dfannin/lart1/schematic/LART1-v6-micro-board.png

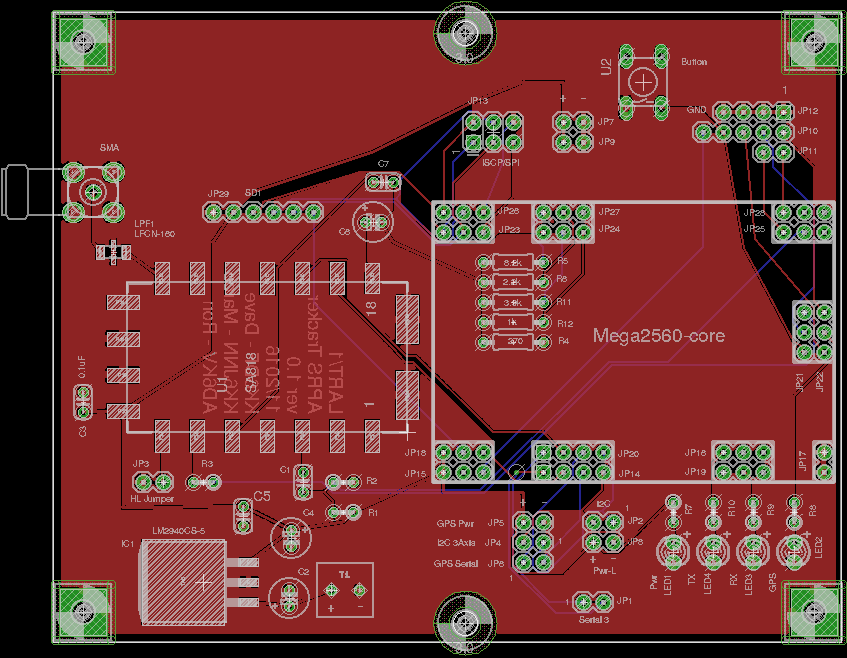
schematic/LART1-v6-micro-board.png
