dfannin/lart1/schematic/LART1-v6a-micro-schematic.png

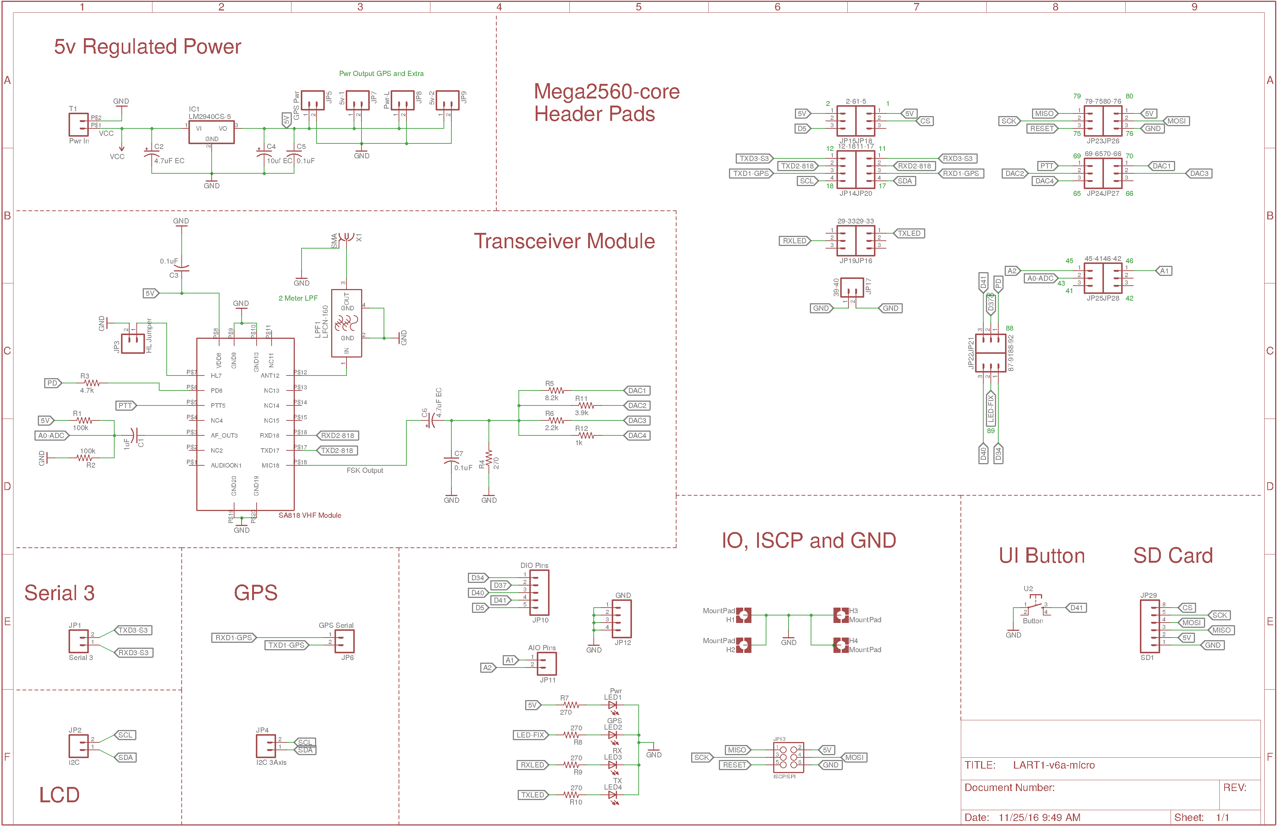
schematic/LART1-v6a-micro-schematic.png
