dfannin/lart1/(threads)

Thread 1 (2016-10-22):

SD Card Interface

dfannin, 2016-10-22:
Desired Features
- add SD card interface
-  read  and set configuration data from SD card (
-  should have a #define switch
- if SD card or data error, then fail to start up

Acceptance Test
- Read and set sample config data
- handle error (fail to startup) on data error

Closed 2016-10-24.

Thread 11 (2016-10-23):

LED pin control for GPS, TX, RX, Pwr

dfannin, 2016-10-23:
Desired Features:
add LED pin control for GPS fix (fix=on)
confirm and test TX/RX LED pins working

Closed 2016-11-01.

Thread 16 (2016-11-02):

Changes for 1.0 Design (Design Review 1)

dfannin, 2016-11-02:
# Changes from the Design Review of Hardware Board

+ Remove SD 2 row Headers, replace SD connector with Mini-SD card connector layout (single row pins)
  + plan to use miniSD card module, relocate on board with no overhang
+ PTT - don't need mosfet switch, just use arduino pins (reverse logic)
+ add add' bypass cap near voltage regulator ic
+ make sure power traces are sized for 1 amp
+ review power input terminal screw block - is the orientation correct? review Poloru to see if clamp down wago connects can be used.
+ group interfacing pins (gps, lcd, etc)  into common blocks  1x or 2x rows. use std sizes
+ add gnd pads to led, to allow board mounting of leds (blinkenlights)
+ add power indicator led (board or remote)
+ tie in ground pour and corner holes ground planes.
+ add test pads to the board.
+ review 818 pads to make sure ground pads work for DRA or SA models.
+ make sure the Mega2560-core pins to usb cable have clearance to be connected after installed.
+ mounting holes for LCD display.
+ alternatives to using SD card for configuration.

dfannin, 2016-11-04:
# Changes made (board v6)

+ (done)  Remove SD 2 row Headers, replace SD connector with Mini-SD card connector layout (single row pins)
  + plan to use miniSD card module, relocate on board with no overhang
+ (done)  PTT - don't need mosfet switch, just use arduino pins (reverse logic)
+ (done) add add' bypass cap near voltage regulator ic
+ (done) make sure power traces are sized for 1 amp - 12mil
+ (done)  review power input terminal screw block - is the orientation correct? review Poloru to see if clamp down wago connects can be used. - NC
+ (done) group interfacing pins (gps, lcd, etc)  into common blocks  1x or 2x rows. use std sizes
+ (done) add gnd pads to led, to allow board mounting of leds (blinkenlights)
+ (done) add power indicator led (board or remote)
+ (done) tie in ground pour and corner holes ground planes.
+  add test pads to the board.
+ (done) review 818 pads to make sure ground pads work for DRA or SA models. -OK
+ (done) make sure the Mega2560-core pins to usb cable have clearance to be connected after installed.
+ (done) mounting holes for LCD display. - added two holes
+ (done) alternatives to using SD card for configuration. - NC

dfannin, 2016-11-04:
# Changes made (board v6)

+ (done) added UI button (tactile switch)
+ (done) added LED outline

Closed 2016-11-05.

Thread 17 (2016-11-06):

Add flexible PTT logic setting

dfannin, 2016-11-06:
Add ability to set PTT logic to ON=true, or OFF=false, or the reverse.  Hardware design updated to remove Mosfet Switch, so the default is now ON=LOW, OFF=HIGH on PTT pin.

Closed 2016-11-07.

Thread 18 (2016-11-06):

Add PD (Power Down) logic for Transceiver

dfannin, 2016-11-06:
Add Arduino code to set PD logic pin to HIGH for operation, and low for power down.
Current behavior for 1.0 will be to set and leave it HIGH.
Pin Number should be set in the #define.

Closed 2016-11-09.

Thread 22 (2016-11-21):

Reversed Jmp16 and Jmp19 on V6 board - breaks TX/RX led assignments

dfannin, 2016-11-21:
the board layout for V6 was incorrect - Jmp 16 and 19 were swapped on the layout. This breaks the LED pin assigments for TX and RX led pins.  Luckily, this can be fixed by reassigning TX to pin D49 and RX to pin D46, and changing the LibAPRS to use DDR pins L0 for TX and L3 for RX.

Closed 2016-11-21.

Thread 26 (2018-06-03):

PCB - add additional ground pad for the voltage regulator

dfannin, 2018-06-03:
PCB - Adding additional space for the SMD voltage regulator ground pad and a thru hold to make it easier to solder on the VR

Thread 27 (2018-06-03):

PCB - remove excess pins and devices

dfannin, 2018-06-03:
- reducing the LEDs from 4 to 1 (maybe zero, and just the Arduino LED)
- remove the 2x3 ISCP pins (jp13)
- remove the 2x2 extra power out pins. (jp7and9)
-  remove the extra IO pins (JP10/11/12) (maybe keep 2 or 3)
-  remove the i2c 3 axis pins (JP4)
-  remove LCD mounting holes remove the LCD i2c and pwr pins ( JP2 and JP8)
-  remove the tactile switch
Most of these were not being used, so it frees up a lot of board space (and power consumption, in the case of the LEDs).  I can reduce the board width about 20mm  with these changes. (from 10x8cm to 10x6cm.  I may leave some of these as holes if I have room.  A lot of these boards are used without the LCD anyway, and its a significant savings for power consumption.

Thread 28 (2018-06-03):

PCB - Change pins to JST-XH

dfannin, 2018-06-03:
Changing the wiring pins (for the GPS, Power Input and Output, and serial port to JST-XH style connectors.

Thread 32 (2018-06-04):

PCB - add header for connecting USB

dfannin, 2018-06-04:
Add header (2 wire d+/d-) JST-XH header for connecting USB cable
also look at option to put USB cable on the board directly (micro-usb)

Thread 34 (2019-11-27):

PCB - please add Gerber file for board

heypete, 2019-11-27:
Hi,

Could you please share the Gerber file for the PCB so one could have the board made?

Thank you.
