dfannin/lart1/LART1.ino

/*
 * Livermore Amateur Radio Klub (LART) APRS Tracker (LART/1)
 *
 * Provides (Automatic Position Reporting System) APRS tracker features that can be used 
 * as an GPS location transmitter "beacon" , and can also function as an  APRS packet receiver.     
 * The design is designed to integrate  the DRA818v/SA818v 2 meter 1 watt transceiver module, and
 * a NMEA compatible GPS module.  
 *
 * The following libraries are required (modified libraries are provided in the repository):
 * LibAPRS - provides the software TNC featuree
 * DRA818 - controls the  2 meter transceiver
 * TinyGPSplus - parses the GPS messages
 * LiquidCrystal_I2C (optional) - provides LCD display
 *
 * The hardware specifications and schematic are provided in the repository. It is designed to
 * run on a Arduino Mega2560 compatible board.
 * 
 * Author: David Fannin, KK6DF
 * Created: October 2016 
 * License: MIT License
 * Licenses and Copyright Notices for Modified Libraries are retained by the original authors. 
 *
 */

#if defined(__AVR_ATmega2560__) 
#define TARGET_CPU mega2560
#endif

#include "Arduino.h" 
#include <avr/sleep.h>
#include "LART1_Settings.h"
#include "LiquidCrystal_I2C.h"
#include "LibAPRS.h"
#include "TinyGPSplus.h"
#include "DRA818.h"
#include "Log.h"
#include "SD.h"
#include "ClickButton.h"

#define VERSION "1.002b"
#define ADC_REFERENCE REF_5V
// various debug flags
// #define DEBUG_APRS_SETTINGS
// #define DEBUG_POSITIONCHECK

// setting DRA818 Filter settings
// transciver filter settings 
// note: "true" bypasses the  filter (turns the filter off), "false"  sets to normal mode (turns on) 
// yes, this is confusing!
#define FILTER_PREMPHASIS false
#define FILTER_HIGHPASS true
#define FILTER_LOWPASS true

//  define APRS_PTT_LOW for TX=LOW hardware
//  or APRS_PTT_HIGH for TX=HIGH hardware
#define APRS_PTT_TX_LOW 

// status led 
//
#define LED_TX 49
#define LED_RX 46
#define LED_GPS 36

#define LED_13 13
//
// Transceiver Ctl pins
// PTT pin (don't change, the pin is used by Port Manipulation later on) 
#define PTT 25

// PowerDown Logic Pin (puts DRA818 into sleep mode)
#define PD 35 

// on-board tactile button (UI button)
// use pullup , so button is active low 
#define BTN1 41
ClickButton btn1(BTN1, LOW, CLICKBTN_PULLUP) ;
int btn1_function = 0 ;

// usb serial port
HardwareSerial  * serialdb   = &Serial ;
// gps port
HardwareSerial  * serialgps  = &Serial1 ;
// DRA818 port
HardwareSerial * dra_serial = &Serial2 ;

// setting the default parameters
char aprs_callsign[7] ;
bool callsign_set = false ;
int  aprs_ssid ;
bool ssid_set = false ;
char aprs_comment[36] ;
bool aprs_beacon = APRS_BEACON  ;
bool aprs_recv = APRS_RECV ;
bool notsosmart_beacon = NOTSOSMART_BEACON ; 
bool sdlog_write = SDLOG_WRITE ;
double txfreq = TXFREQ ;  
double rxfreq = RXFREQ ;
int txctcss = TXCTCSS ;
int rxctcss = RXCTCSS ;
int volume = VOL ;
int squelch = SQUELCH ;

bool open_squelch = OPEN_SQUELCH ;
char aprs_dest[7]  ;
char aprs_path1[7] ;
int aprs_path1_ssid =PATH1_SSID ;
char aprs_path2[7] ;
int aprs_path2_ssid = PATH2_SSID ;
int  preamble = PREAMBLE;
int  tail = TAIL;
char aprs_symbol  = SYMBOL ;
bool aprs_alt_symbol = USE_ALT_SYM_TABLE  ;
unsigned long bklight_interval = BKLIGHT_INTERVAL ;

unsigned long update_beacon = UPDATE_BEACON_INIT ;

unsigned long update_beacon_fixed = UPDATE_BEACON_FIXED ;
unsigned long update_beacon_moving = UPDATE_BEACON_MOVING ;

// set the outer beacon check loop to 30 seconds (do not change).
unsigned long update_check = 30000L ;
unsigned long lastcheck = 0 ;
unsigned long lastupdate = 0 ;
unsigned long lastupdatedisplay = 0 ;
unsigned long lastgpsupdate = 0 ;

float mph_threshold = MPH_THRESHOLD ;

unsigned long update_led = 0 ;
unsigned long update_led_interval = 500UL ;


int sent_count=0 ;

#if OPTION_LCD
LiquidCrystal_I2C lcd(0x27, 2, 1, 0, 4, 5, 6, 7 , 3, POSITIVE); 
unsigned long bklighttimer = 30000UL ;
#endif
bool bklightstate = true ;


// GPS 
TinyGPSPlus gps ;

// DRA818 Transceiver Module
DRA818 dra(dra_serial, PTT);

// Log
Log mylog;


char buf[120] ;

boolean gotPacket = false ;
int recv_count = 0 ;
AX25Msg incomingPacket;
uint8_t *packetData;

void aprs_msg_callback(struct AX25Msg *msg)
{
   if(!gotPacket) {
      gotPacket = true ;
      memcpy(&incomingPacket, msg, sizeof(AX25Msg));
      if (freeMemory() > (int16_t)  msg->len) {
         packetData = (uint8_t*) malloc(msg->len);
         memcpy(packetData,msg->info,msg->len);
         incomingPacket.info=packetData;
      } else {
         gotPacket = false ;
      }
   }
}


void processPacket()
{
   if(gotPacket) {
      char outbuf[180] ; 
      char tmpbuf[120];

      gotPacket = false ;
      recv_count++ ;

      outbuf[0] = '\0';
      strcpy(tmpbuf,"00-00 00:00:00 ") ;

      if ( aprs_recv ) {

          if( gps.date.isValid() ) {
              sprintf(tmpbuf,"%02d-%02d %02d:%02d:%02d ", 
                      gps.date.month(), gps.date.day(),
                      gps.time.hour(), gps.time.minute(), gps.time.second()
                     ) ;
          } 


          strcat(outbuf,tmpbuf) ;

          sprintf(tmpbuf,"%s-%d,%s-%d",
                  incomingPacket.src.call, incomingPacket.src.ssid, 
                  incomingPacket.dst.call, incomingPacket.dst.ssid );

          strcat(outbuf,tmpbuf) ;

          int i = 0 ; 
          for(i = 0; i < incomingPacket.rpt_count ; i++) {
            sprintf(tmpbuf," %s-%d",incomingPacket.rpt_list[i].call, incomingPacket.rpt_list[i].ssid);
            strcat(outbuf,tmpbuf) ;
          }

          int maxlen = incomingPacket.len ; 

          if ( strlen(outbuf) + maxlen > 179 ) maxlen = 179 - strlen(outbuf) ;

          for(i = 0; i < maxlen ; i++) {
               tmpbuf[i]  = (char) incomingPacket.info[i] ;
          }

          strcat(outbuf,tmpbuf) ;
          serialdb->println(outbuf) ;
          // mylog.send(outbuf) ;
      }


      free(packetData) ;

      // serialdb->print(F("Free Ram:")) ;
      // serialdb->println(freeMemory()) ;

   }
}


void locationUpdate(const char *lat, const char *lon,int altitude)
{
   char comment[43] ; // max of 36 chars with PHG data extension, 43 chars  without
   APRS_setLat(lat);
   APRS_setLon(lon);
   sprintf(comment,"/A=%06d%s",altitude,aprs_comment) ;
   APRS_sendLoc(comment, strlen(comment),serialdb);
}

/*
 simplifed in 1.002a

void locationUpdate(const char *lat, const char *lon,int altitude, int height = 0 ,int power=1, int gain=0, int dir=0)
{
   char comment[43] ; // max of 36 chars with PHG data extension, 43 chars  without
   APRS_setLat(lat);
   APRS_setLon(lon);
   // APRS_setHeight(height);
   // APRS_setPower(power);
   // APRS_setGain(gain);
   // APRS_setDirectivity(dir);
   sprintf(comment,"/A=%06d%s",altitude,aprs_comment) ;
   APRS_sendLoc(comment, strlen(comment),serialdb);
}
*/


double  ddtodmh(float dd) {

    double  value = dd ;
    double  degrees =  floor(value) ;
    value = ( value - degrees ) * 60  ;
    double  minutes =  floor(value ) ; 
    value =  (value - minutes) ;
    return ( degrees*100 ) + minutes + value ; 
}



void mytrim(char * str) {
    int i ; 
    int begin = 0 ;
    int end = strlen(str) - 1 ; 
    while ( isspace((unsigned char) str[begin])) begin++ ;
    while (( end >= begin) && isspace((unsigned char) str[end])) end-- ;
    for( i = begin; i<=end ; i++ ) str[i-begin] = str[i] ;
    str[i-begin] = '\0';
}


void setParam(int p, const char *buf) {

    switch(p) {
        case 1:
            strncpy( aprs_callsign, buf, 6 );
            aprs_callsign[ 6] ='\0';
            if (strlen(aprs_callsign) > 2) callsign_set = true ;
            break ;
        case 2:
            aprs_ssid = atoi(buf);
            if ( aprs_ssid >= 0 && aprs_ssid < 16 ) ssid_set = true ;
            break ;
        case 3:
            strncpy( aprs_comment, buf, 35);
            aprs_comment[35]='\0' ;
            break ;
        case 4:
            aprs_beacon =(bool)  atoi(buf) ;
            break ;
        case 5:
            aprs_recv = (bool) atoi(buf) ;
            break ;
        case 6:
            notsosmart_beacon = (bool) atoi(buf) ;
            break ;
        case 7:
            sdlog_write = (bool) atoi(buf) ;
            break ;
        case 8:
            txfreq =  atof(buf) ;
            break ;
        case 9:
            rxfreq =  atof(buf) ;
            break ;
        case 10:
            txctcss =  atoi(buf) ;
            if ( txctcss < 0 || txctcss > 38 ) txctcss = 0 ;
            break ;
        case 11:
            rxctcss =  atoi(buf) ;
            if ( rxctcss < 0 || rxctcss > 38 ) rxctcss = 0 ;
            break ;
        case 12:
            volume =  atoi(buf) ;
            if ( volume < 1 || volume > 8 ) volume = 5 ; 
            break ;
        case 13:
            squelch =  atoi(buf) ;
            if ( squelch < 0 || squelch > 8 ) squelch = 2 ; 
            break ;
        case 14:
            open_squelch = (bool) atoi(buf) ;
            break ;
        case 15:
            strncpy( aprs_dest, buf, 6 );
            aprs_dest[6] ='\0';
            break ;
        case 16:
            strncpy( aprs_path1, buf, 6 );
            aprs_path1[6] ='\0';
            break ;
        case 17:
            aprs_path1_ssid =  atoi(buf) ;
            if ( aprs_path1_ssid < 0 ||  aprs_path1_ssid > 15 ) aprs_path1_ssid = 1 ;
            break ;
        case 18:
            strncpy( aprs_path2, buf, 6 );
            aprs_path2[6] ='\0';
            break ;
        case 19:
            aprs_path2_ssid =  atoi(buf) ;
            if ( aprs_path2_ssid < 0 ||  aprs_path2_ssid > 15 ) aprs_path2_ssid = 1 ;
            break ;
        case 20:
            preamble =  atol(buf) ;
            break ;
        case 21:
            tail =  atol(buf) ;
            break ;
        case 22:
            aprs_symbol = buf[0] ;
            break ;
        case 23:
            aprs_alt_symbol = (bool) atoi(buf) ;
            break ;
        case 24:
            bklight_interval =  atol(buf) ;
            break ;
        case 25:
            update_beacon_fixed =  atol(buf) ;
            break ;
        case 26:
            update_beacon_moving =  atol(buf) ;
            break ;
        case 27:
            mph_threshold =  atof(buf) ;
            break ;
        default:
            break ;
    } 
} 


bool readConfig(File *cf) {

    int ccnt = 0 ;
    int pnum = 0 ;  
    char pbuf[50] ;
    char pnumbuf[10] ;

    bool pnmode = true ;
    bool cmode = false ;
    bool cferror = false ;


    pbuf[0] = '\0';

    while (cf->available()) {

        char c = cf->read() ; 

        // terminate the line and set the param on CR or LF
        if ( c == '\r' || c == '\n' ) {
            // if the next char is NL or CR, then slurp it up
            // should work for win, linux or mac edited files
            if ( cf->peek() == '\n' || cf->peek() == '\r') {
                cf->read() ;
            }
            mytrim(pbuf) ;

            if ( strlen(pbuf) > 0 || pnum != 0 ) setParam(pnum, pbuf) ;
            ccnt = 0  ;
            pnum = 0 ; 
            pbuf[0] = '\0' ;
            pnumbuf[0]= '\0';
            cmode = false  ;
            pnmode = true ;
            continue ;
        }


        if ( cmode ) { 
            continue ;
        }


        if ( c ==  '#'  || ccnt > 48 ) {
            cmode = true ;
            continue ;
        }


        if (pnmode) {
            // if the parameter number is not found, then punt and ignore the line
            if ( ccnt > 9 ) {
                cmode = true ;
                cferror = true ; 
                pnmode = false ;
                ccnt = 0 ;
                continue ;
            }
            // when the number is read
            // move to reading the parameter value
            if ( c == ',' ) {
                pnmode = false ;
                ccnt = 0 ; 
                pnum  = atoi(pnumbuf) ;
                continue ;
            } 

            // read the parameter number and store in a buffer

            pnumbuf[ccnt++] = c ; 
            pnumbuf[ccnt] = '\0' ;
            continue ; 

        }

        pbuf[ccnt++] =  c ; 
        pbuf[ccnt] = '\0' ;

    }

    return !cferror ;
    
}


// blinks the LEDs on startup
//
void testleds(void) {
   pinMode(LED_TX,OUTPUT) ;
   pinMode(LED_RX,OUTPUT) ;
   pinMode(LED_GPS,OUTPUT) ;
   pinMode(LED_13,OUTPUT) ;

   digitalWrite(LED_TX,HIGH) ;
   digitalWrite(LED_RX,HIGH);
   digitalWrite(LED_GPS,HIGH) ;
   digitalWrite(LED_13,HIGH) ;
   delay(1000) ;
   digitalWrite(LED_TX,HIGH) ;
   digitalWrite(LED_RX,LOW);
   digitalWrite(LED_GPS,LOW) ;
   digitalWrite(LED_13,LOW) ;
   delay(1000) ;
   digitalWrite(LED_TX,LOW);
   digitalWrite(LED_RX,HIGH) ;
   delay(1000) ;
   digitalWrite(LED_RX,LOW) ;
   digitalWrite(LED_GPS,HIGH) ;
   delay(1000) ;
   digitalWrite(LED_GPS,LOW) ;
   digitalWrite(LED_13,HIGH) ;
   delay(1000) ;
   digitalWrite(LED_13,LOW) ;
} 

// halt command
void myabort() {
#if OPTION_LCD
    lcd.setBacklight(LOW) ; 
#endif
    cli() ;
    sleep_enable() ;
    sleep_cpu() ;
}


#if OPTION_LCD
bool backlight(bool newlcdstate) {
static  bool lcdstate =  false ; 

if ( newlcdstate  != lcdstate) {
    if ( ! lcdstate )  bklighttimer = millis() ;
    lcdstate = newlcdstate ; 
    lcd.setBacklight(lcdstate) ; 
} else {
    if ( lcdstate && 
         ( bklighttimer < millis() ) &&  
         ( millis() - bklighttimer)  > bklight_interval ) { 
        lcdstate = false;
        lcd.setBacklight(lcdstate) ; 
    }
}

return lcdstate ;
}
#endif



void setup()
{
   // initializes the PTT to high or low
   // set to HIGH, if PTT is LOW to TX
   // set to LOW   if PTT is HIGH to TX
   pinMode(PTT, OUTPUT) ;
   digitalWrite(PTT, HIGH ) ;
   // initializes PD pin to HiGH for DRA818
   // keeps the DRA818 active
   pinMode(PD, OUTPUT) ;
   digitalWrite(PD, HIGH) ;


   // initialize string variables 
   strcpy(aprs_comment,APRS_COMMENT) ;
   strcpy(aprs_dest,APRS_DEST) ;
   strcpy(aprs_path1,PATH1) ;
   strcpy(aprs_path2,PATH2) ;

   serialdb->begin(USB_PORT_BAUD) ;

   serialdb->println(F("Start.")) ;


   dra_serial->begin(DRA818_PORT_BAUD) ;
   serialgps->begin(GPS_PORT_BAUD) ;


#if OPTION_LCD
   mylog.Log_Init(serialdb, &lcd, LCDCOL, LCDROW) ;
   mylog.send(F("LCD Init")) ;
#else
   mylog.Log_Init(serialdb) ;
   mylog.send(F("No LCD")) ;
#endif

   mylog.send(F("LART/1 APRS TRAK")) ;
   delay(1000) ;
   mylog.send(F("LED Test")) ;

   testleds() ;

   if ( !SD.begin(4) ) {
       mylog.send(F("sd init fail")) ; 
       delay(10000) ;
       myabort() ;
   }


   const char *fname = "/config.txt" ;

   File configFile  = SD.open(fname) ; 

   if (! configFile) {
       mylog.send(F("no cfg file")) ; 
       delay(10000) ;
       myabort() ;
   }

   if (!readConfig(&configFile) )  {
       mylog.send(F("cfg read fail")) ; 
       delay(10000) ;
       myabort() ;
   }

   if ( ! callsign_set || ! ssid_set ) {
       mylog.send(F("call error")) ; 
       delay(10000) ;
       myabort() ;
   }

   mylog.send(F("cfg ok")) ; 
   configFile.close() ;

   sprintf(buf,"CS:%s-%d",aprs_callsign,aprs_ssid);  
   mylog.send(buf) ;
   delay(1000UL) ;

   sprintf(buf,"Ver: %s",VERSION);  
   mylog.send(buf);
   delay(1000UL);

   // DRA818 Setup
   // must set these, then call WriteFreq
   //
   if ( dra.heartbeat() )  {
       mylog.send(F("Txcr OK Chk")) ;
   } else {
       mylog.send(F("Txcr Fail Chk")) ;
       delay(10000) ;
       myabort() ;
   } 
   delay(500UL);

   // set freq and tones
   dra.setFreq(txfreq,rxfreq);
   dra.setTXCTCSS(txctcss);
   dra.setSquelch(squelch);
   dra.setRXCTCSS(rxctcss);
   dra.setBW(BW); // 0 = 12.5k, 1 = 25k

   char fbuf[12] ;
   if ( dra.writeFreq() ) {
       dtostrf(txfreq, 8, 4, fbuf) ;
       sprintf(buf,"TX:%s",fbuf) ;
       mylog.send(buf);
       sprintf(buf,"TXpl:%d",txctcss) ;
       mylog.send(buf);
       delay(1000UL);
       dtostrf(rxfreq, 8, 4, fbuf) ;
       sprintf(buf,"RX:%s",fbuf) ;
       mylog.send(buf);
       sprintf(buf,"RXpl:%d",rxctcss) ;
       delay(1000UL);
    } else {
        mylog.send(F("Freq Fail"));
       delay(10000) ;
       myabort() ;
    }

   if ( dra.setVolume(volume) ) {
       sprintf(buf,"Vol: %d", volume) ;
       mylog.send(buf);
       delay(500UL);
       sprintf(buf,"Sql: %d", squelch) ;
       mylog.send(buf);
       sprintf(buf,"OpenSql: %d", open_squelch) ;
       mylog.send(buf);
       delay(500UL);

    } else {
        mylog.send(F("Vol Fail"));
       delay(10000);
       myabort();
    } 


   if ( dra.setFilters(FILTER_PREMPHASIS, FILTER_HIGHPASS, FILTER_LOWPASS) ) {
      sprintf(buf,"Filter: %d %d %d",FILTER_PREMPHASIS,FILTER_HIGHPASS,FILTER_LOWPASS) ;
      mylog.send(buf);
   } else { 
      mylog.send( F("Filter Fail") );
       delay(10000) ;
       myabort() ;
   }


   delay(500UL);

   dra.setPTT(PTT_OFF);
   delay(500UL);

   mylog.send(F("APRS setup")) ;
   APRS_init(ADC_REFERENCE, open_squelch);
   APRS_setCallsign(aprs_callsign, aprs_ssid);
   APRS_setDestination(aprs_dest,0);
   APRS_setPath1(aprs_path1,aprs_path1_ssid);
   APRS_setPath2(aprs_path2,aprs_path2_ssid);
   APRS_setPreamble(preamble);
   APRS_setTail(tail);
   APRS_useAlternateSymbolTable(aprs_alt_symbol) ;
   APRS_setSymbol(aprs_symbol);
   if (aprs_beacon) APRS_printSettings(serialdb) ;
   delay(500UL) ;

   sprintf(buf,"Receive Mode %d",aprs_recv) ;
   mylog.send(buf) ;

   sprintf(buf,"Beacon Mode %d",aprs_beacon) ;
   mylog.send(buf) ;
   delay(500UL) ;

   sprintf(buf,"NotSmart Mode %d",notsosmart_beacon) ;
   mylog.send(buf) ;

   if ( notsosmart_beacon ) {
      dtostrf(mph_threshold, 6, 1, fbuf) ;
      sprintf(buf,"MPH Thres: %s",fbuf) ;
      mylog.send(buf) ;
   }

   delay(500UL) ;


#ifdef APRS_PTT_TX_LOW 
   sprintf(buf,"PTT Logic LOW") ;
#else
   sprintf(buf,"PTT Logic HIGH") ;
#endif 
   mylog.send(buf) ;

   btn1.debounceTime = 50 ;
   btn1.multiclickTime = 500 ;

   mylog.send(F("Setup Complete")) ;
   delay(500UL) ;
   mylog.send(F("Ready")) ;

}

char  lat[] =  "0000.00N" ;
char  lon[] = "00000.00W" ;
double latd = 0.0 ;
double lond = 0.0 ;

// char  prevlat[] =  "0000.00N" ;
// char  prevlon[] = "00000.00W" ;
double prevlatd = 0.0 ;
double prevlond = 0.0 ;

int alt = 0 ;

bool position_triggered = false ;
bool firsttimethru = true ;

double mph ;



void loop()
{

if ( ( millis() - update_led) > update_led_interval ) {
   digitalWrite(LED_13,LOW) ;
   update_led = millis() ;
}

// process the gps packets
while(serialgps->available() > 0 ) { 
       
    // when we get a gps message
   if ( gps.encode( serialgps->read() ) )  {
       digitalWrite(LED_13,HIGH) ;
       update_led = millis() ;

       if( gps.location.isValid() ) {
          double dmh ; 
           latd = gps.location.lat() ;
           lond = gps.location.lng() ;
           // latitude
           if ( gps.location.rawLat().negative ) {
               dmh = ddtodmh( -latd )  ;
               dtostrf(dmh,7,2,lat) ;
               lat[7] = 'S';
           } else {
               dmh = ddtodmh( latd )  ;
               dtostrf(dmh,7,2,lat) ;
               lat[7] = 'N';
           }
           // longitude
           if ( gps.location.rawLng().negative ) {
               dmh = ddtodmh( -lond )  ;
               dtostrf(dmh,8,2,lon) ;
               lon[8] = 'W';
           } else {
               dmh = ddtodmh(lond )  ;
               dtostrf(dmh,8,2,lon) ;
               lon[8] = 'E';
           }

       } // end lat lon update 

           // altitude 
       if ( gps.altitude.isValid() ) {
           alt = (int) gps.altitude.feet() ;
       } // end altitude update 
    }

} // end readgps 

   // check if position has changed
   if ( ( millis() - lastgpsupdate )   >   30000  ) { 
           double elapsedsec =   ( millis() - lastgpsupdate ) / 1000.0 ;
           lastgpsupdate = millis() ;

           if ( gps.location.isValid() ) {
               // caluclate distance
               double dist  = gps.distanceBetween(latd, lond, prevlatd, prevlond) ;
               // convert to miles
               dist  = dist * 0.0006214 ; 

               mph =  ( dist / elapsedsec  ) * 3600.0 ;

               if ( mph >= mph_threshold ) {
                   position_triggered = true ; 
               } 


#ifdef DEBUG_POSITIONCHECK
               char mbuf[20] ;
               char dbuf[20] ;
               dtostrf(mph, 6, 1, mbuf) ;
               dtostrf(dist, 12, 4, dbuf) ;
               sprintf(buf,"mph:%s d:%s",mbuf,dbuf) ;
               mylog.send(buf) ;
               sprintf(buf,"update beacon:%lu",update_beacon) ;
               mylog.send(buf);
#endif

               prevlatd = latd ;
               prevlond = lond ;
          }

   }


   // outer update check loop 
   if (aprs_beacon  && ( millis() - lastcheck) > update_check ) {
       lastcheck = millis () ;

       // don't do anything unless gps is valid
       if ( gps.location.isValid() )  {

           if ( notsosmart_beacon ) {
              if ( position_triggered ) {
                 update_beacon = update_beacon_moving ; 
              } else {
                 update_beacon = update_beacon_fixed ;
              } 
           } else { 
              // add this to make sure the location is sent first time thru the loop
              if (firsttimethru) {
                update_beacon = update_beacon_moving ;
              } else {
                update_beacon = update_beacon_fixed ;
              }
           } 

           // if its time, send out the location
           if ( (millis() - lastupdate) > update_beacon ) {
              lastupdate = millis() ;
              locationUpdate(lat,lon,alt) ;
              delay(25) ;
              serialdb->println(F("location sent")) ;
              sent_count++ ;
              position_triggered = false ;
              firsttimethru = false ;
          }
       }
   }

   // read (and output received packets
   processPacket() ;


// update button state
    btn1.Update() ;

    if (btn1.clicks != 0 ) btn1_function = btn1.clicks ; 

    // single click = reset the backlight timer
    if (btn1.clicks == 1 ) {
        bklightstate = !bklightstate ; 
    }

#if OPTION_LCD
    bklightstate = backlight(bklightstate) ;
#endif

        if ( (millis() - lastupdatedisplay) > UPDATE_DISPLAY ) {
        lastupdatedisplay = millis() ;
        sprintf(buf,"s:%d r:%d",sent_count,recv_count) ;
        mylog.send(buf) ;

        if ( gps.location.isValid() )  {
             char datebuf[20] ; 
             sprintf(datebuf,"%02d-%02d %02d:%02d:%02d", 
                  gps.date.month(), gps.date.day(),
                  gps.time.hour(), gps.time.minute(), gps.time.second()
                 ) ;
            mylog.send(datebuf) ;
        } else {
            mylog.send(F("gps no fix")) ;
        }


#ifdef DEBUG_APRS_SETTINGS
        APRS_printSettings(serialdb) ;
#endif

         // update gps led

         digitalWrite(LED_GPS, ( gps.location.isValid() && gps.location.isUpdated() ) ) ;
       }
}
