dfannin/lart1/(commit log)

2016-09-19 fixed version compile error
    [LART1.ino]
2016-09-21 added processPacket print to lcd, moved Transceiver Setup, working version
2016-10-05 beta version, works with gps, wrong DD conversion
    [LART1.ino]
2016-10-08 beta version, with GPS, working, added new schematics
2016-10-20 Beta Update - working code, added decoding, mega board
2016-10-20 fixed log output (one 1line), added comment altitude, fixed some typos
    [LART1.ino]
2016-10-22 fixed DRA818 readresponse - race condition on read, added timeout on interchar delay
    [LART1.ino]
2016-10-22 printout packet data, created separate Settings.h file, cleaned up and added new definitions
2016-10-23 added software switches for Beacon and Receive Modes Closes #4 added Smart Beacon Mode Closes #3
2016-10-24 SD Card Interface Closes #1 reads config data from SD card - only 3 parameters set - callsign, ssid and comment - no define switch yet
2016-10-25 added config file sample added recommended hardware list
    [config.txt]
2016-10-27 updated the hardware suggested list
    (removed the mega board suggestion)
2016-10-27 resolveing issues with the repo fixing tinygps files removing liquidcrystal_i2c docs not needed
    [LART1.ino, LART1_Settings.h]
2016-10-28 added new board and schematic removed out of date docs
2016-10-28 adding new board and schematic
2016-10-30 Added new cfg file format (para num, para value) not backwards compatible with old format adds parameter number to file added reading/setting of 4 new parameters
    [config.txt]
2016-10-31 Update to Beta-0.999l new config file format: added parameter number added txfreq,rxgreq,ctcss, vol and squelch to sd config params added update_beacon_fixed, _moving to sd config params fixed receiv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
    [LART1.ino]
2016-11-01 update to Beta-0.999m LED pin control for GPS Fix, TX and RX Closes #11 added startupl led blinking added led pin turn on when GPS fix is achevied changed gps control loop ,reads gps data coninuously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
    [config.txt]
2016-11-03 1.0 fixes reverted to previous gps.encode reading style seperated out gps check , to check at fixed interval (30 seconds) created variables for possible "miles per hour" checking
    [LART1.ino]
2016-11-05 Updated Schematic and Boards to v6 Closes #16
2016-11-07 updated to Beta-0.999o closes #17 closes #14 added flexible PTT logic setting (for TX=low or high circuits) modified DRA818 and LibAPRS for flexible PTT logic (needed for board v6) updated schematics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
2016-11-09 Update to Beta-0.999p Closes #18 added Power Down pin control (used in the PCB board)
2016-11-09 updated Docs for 1.0 milestone added pintout listing added BOM added 3d rendering image
    [LART1-v6-micro-BOM.csv]
2016-11-10 Add OPTION_LCD Closes #20 added OPTION_LCD - software switch to output to LCD Added LCDCOL and LCDROW to specify row/col sizes
    [config.txt]
2016-11-21 upgrade to 0.999r closes #22 Reversed jmp16 and jmp 19 on V6 board fixes the TX/RX leds will leave V6 in this state
    [LART1.ino]
2016-11-24 update to Beta-0.999s Closes #13 Added interface button for single click - toggle backlight timeout after BACKLIGHTTIMEOUT (compile time)
2016-11-25 update to Beta-0.999t closes closes #21 added all config.txt file settings added config.txt file param checking added halt (myabort) for startup error removed year in timestamps added settable bkligh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
    [config.txt]
2016-11-25 Updated Documentation and Images updated schematic for led pin changes updated pin assignment docs updated readme.md file
2016-11-25 update to Beta-0.999u added lcd backlight turnoff on halt printout DRA818 settings
2016-11-27 updating to Beta-0.999v adding led pin13 to blink when receiving GPS messages.
2016-12-03 updating to Beta-0.999w adding sw swtich to add display guard timing(off by default) adding sw switch to add Neo8m GPS messages recognition (off by default)
2017-02-04 upgraded to 0.999x MPH Thresholding Closes #24 Change position trigger to MPH Thresholding remove forcedisplay and display guard timing
    [config.txt]
2017-07-09 updating to 1.001a Fixes leading zeros Closes #25
    [LART1.ino]
2018-11-14 v1.02b fixed location bug, cleaned up compile warnings
    [LART1.ino]
